JanDerogee/COMMOPAD/images/schematic.JPG

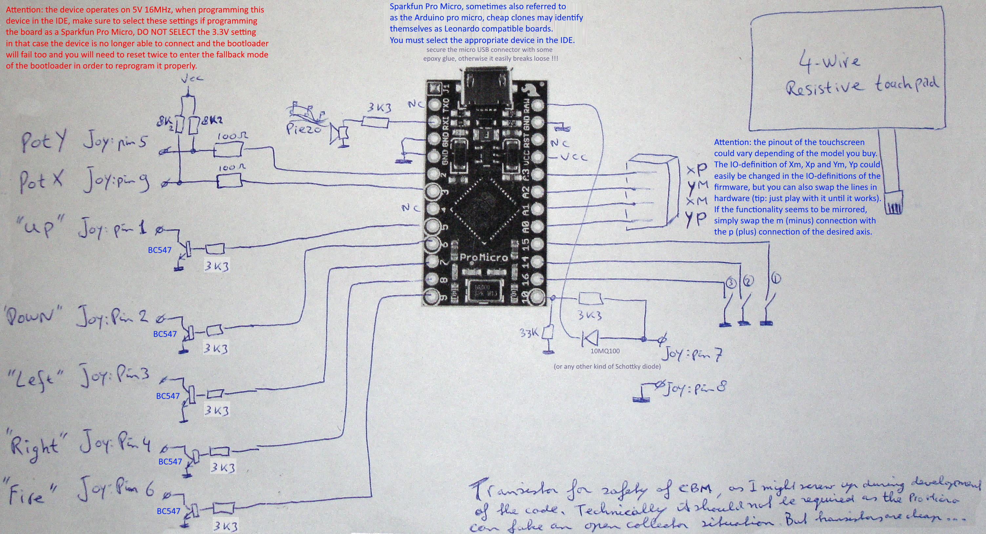
images/schematic.JPG
