JanDerogee/COMMOPAD/images/workings/ADC_simplistic.JPG

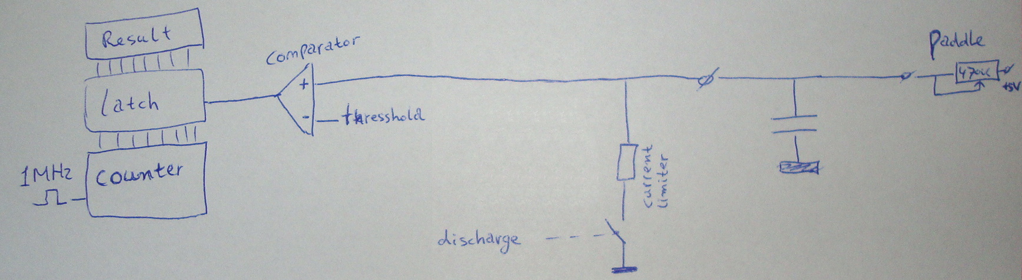
images/workings/ADC_simplistic.JPG
