JanDerogee/COMMOPAD/images/background/Locator_Grid - kopie.jpg

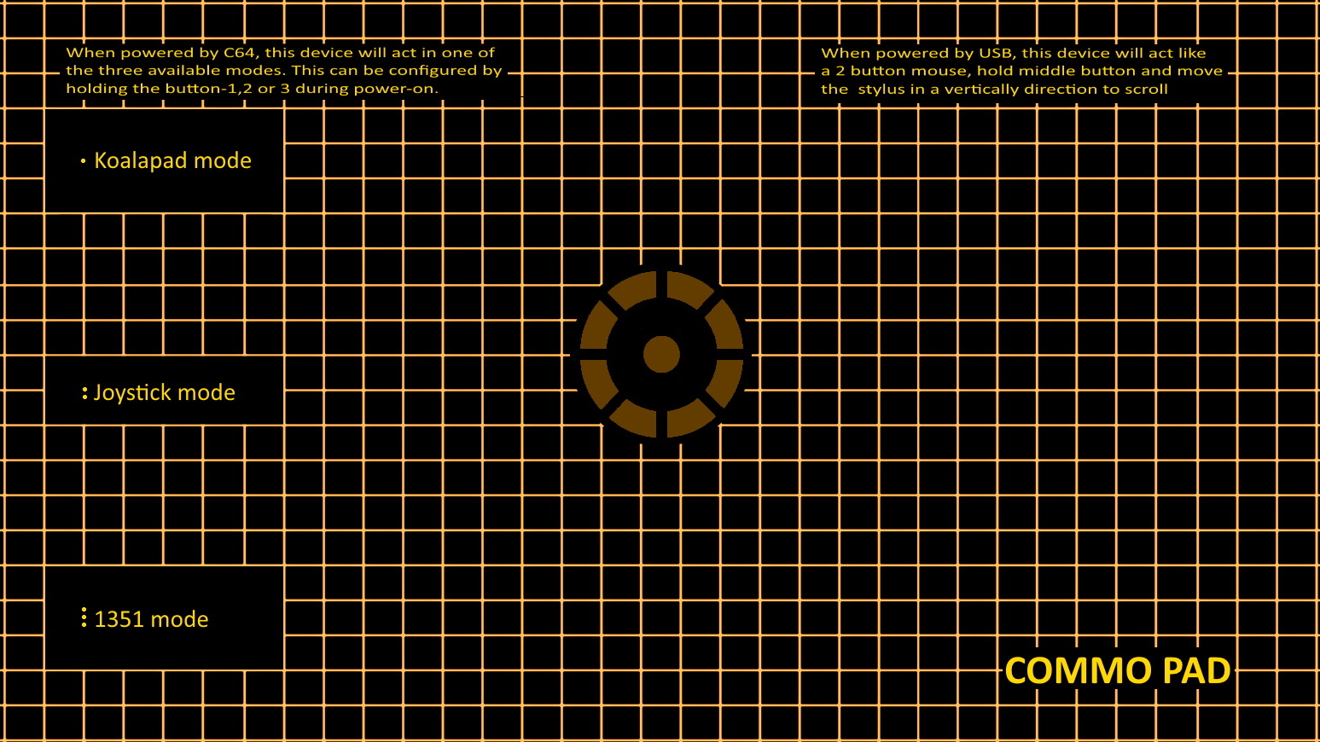
images/background/Locator_Grid - kopie.jpg
