JanDerogee/COMMOPAD/images/background/Locator_Grid.jpg

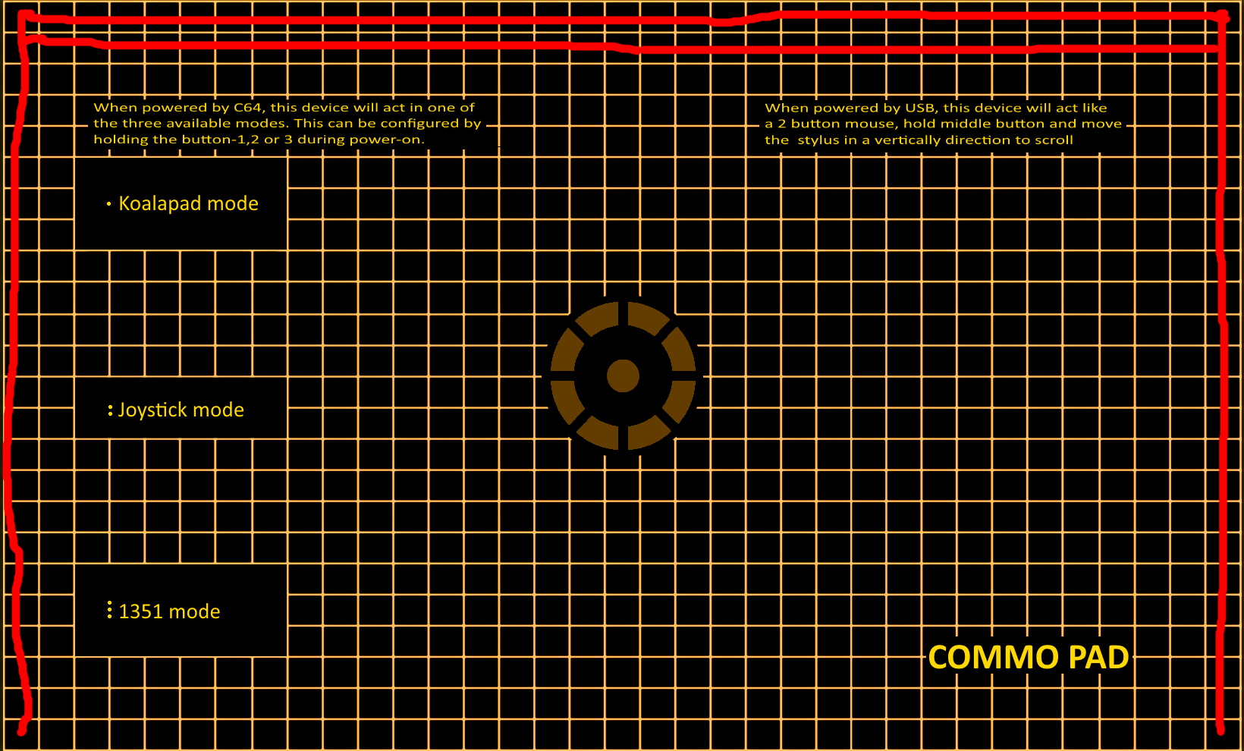
images/background/Locator_Grid.jpg
