JanDerogee/COMMOPAD/images/foto/commo_pad.JPG

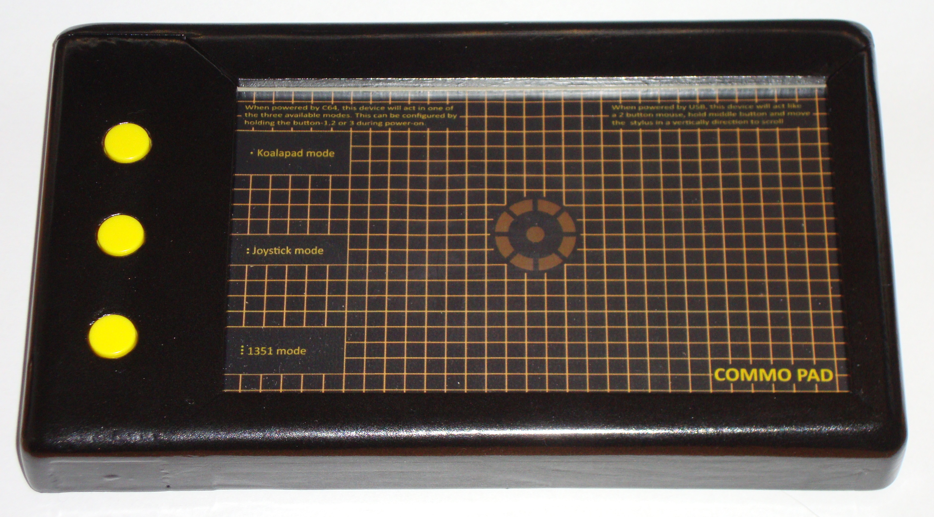
images/foto/commo_pad.JPG
