JanDerogee/COMMOPAD/images/foto/commo_pad_inside.JPG

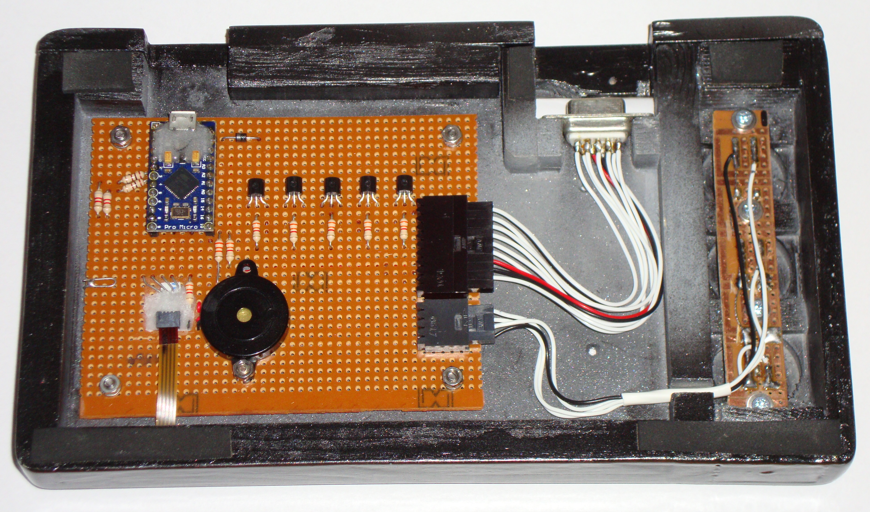
images/foto/commo_pad_inside.JPG
