JanDerogee/COMMOPAD/images/foto/commo_pad_inside_c64.JPG

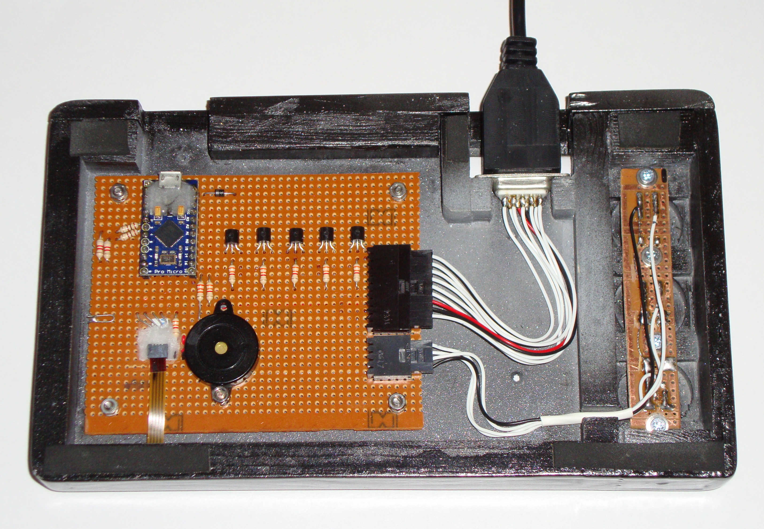
images/foto/commo_pad_inside_c64.JPG
