JanDerogee/COMMOPAD/images/foto/commo_pad_inside_USB.JPG

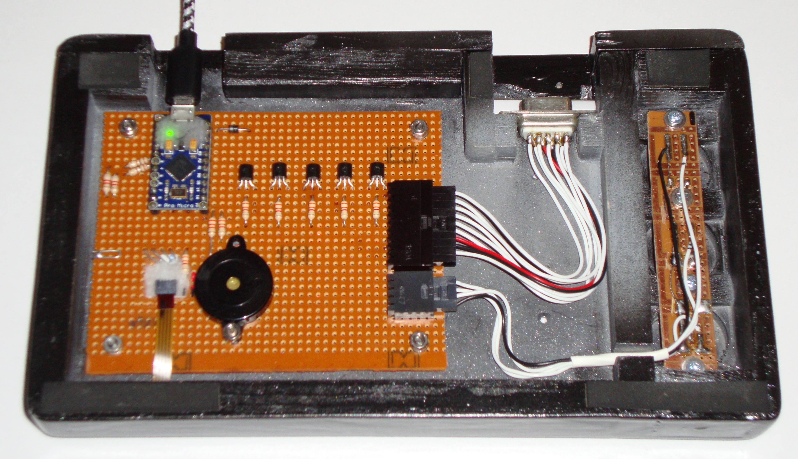
images/foto/commo_pad_inside_USB.JPG
