JanDerogee/COMMOPAD/images/foto/connection_C64.JPG

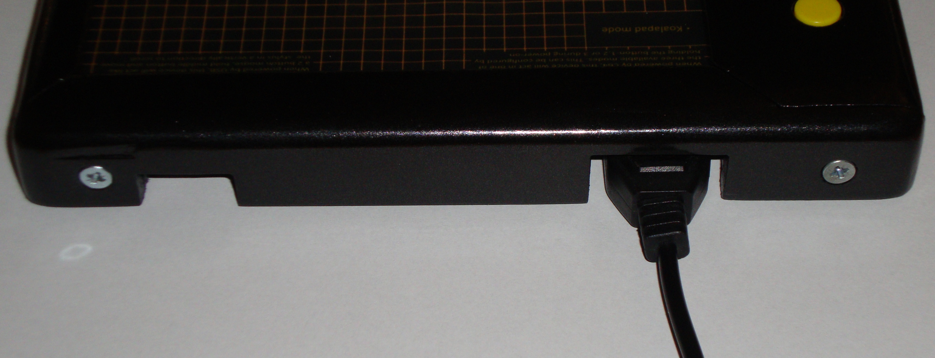
images/foto/connection_C64.JPG
