JanDerogee/COMMOPAD/images/foto/connection_USB.JPG

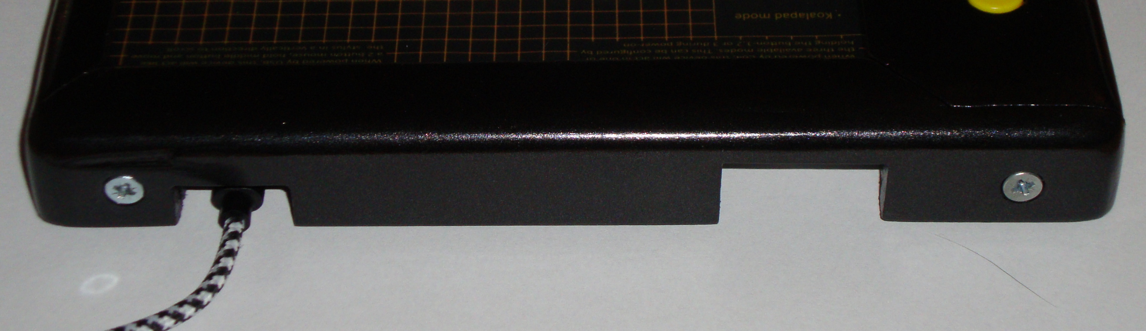
images/foto/connection_USB.JPG
