JanDerogee/COMMOPAD/images/foto/touch panel.jpg

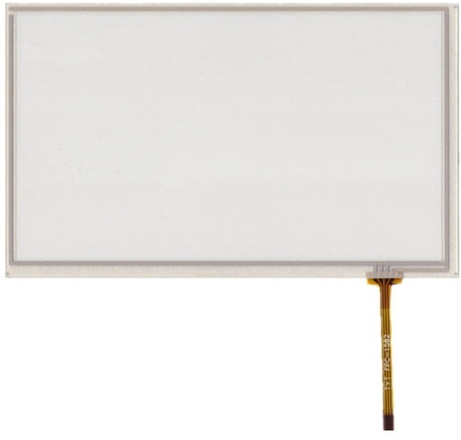
images/foto/touch panel.jpg
