JanDerogee/COMMOPAD/images/workings/minimal_delay_after_mux_change.JPG

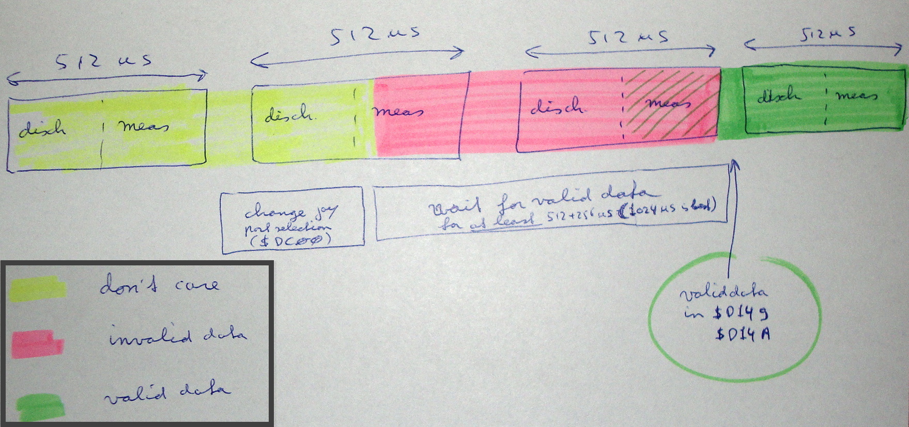
images/workings/minimal_delay_after_mux_change.JPG
