JanDerogee/COMMOPAD/images/workings/mux_definition.JPG

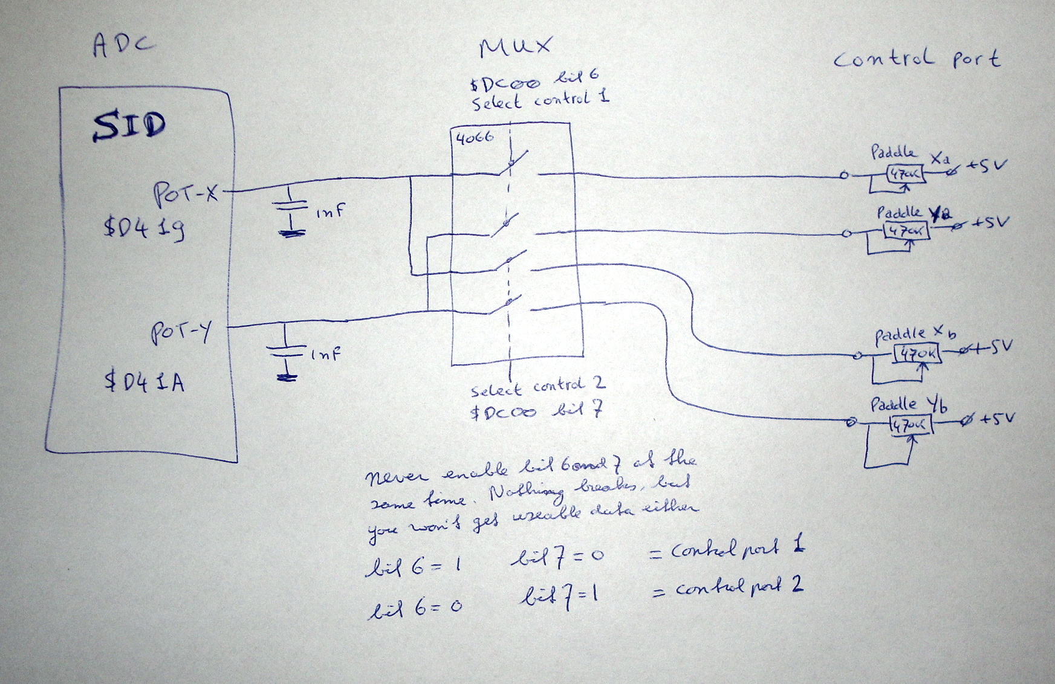
images/workings/mux_definition.JPG
