JanDerogee/COMMOPAD/images/workings/Simple_device_image.png

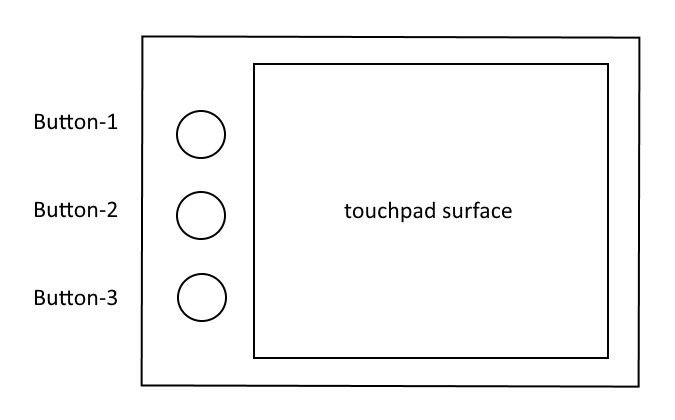
images/workings/Simple_device_image.png
