JanDerogee/COMMOPAD/(commit log)

2022-05-26 Delete schematic.JPG
    making place for version with more info
2022-05-26 added schematic
    the same old schematic but now with some extra notes
2023-04-23 Joystick firebutton bugfix
    Oops, firebutton behavior was wrong, fixed. The new situation has button 1 and 3 for normal fire-button functionality and button 2 is the autofire function, which overrules the buttons 1 and 3.
    [commo_pad.ino]
